Rick-G1/Atmel-ISP-Programmer-using-ProMicro/(notices)

Notices in the files:
README.md:
License: MIT
